Yu-hotspring/BM83/3dmodels/knobs-board-preview.png

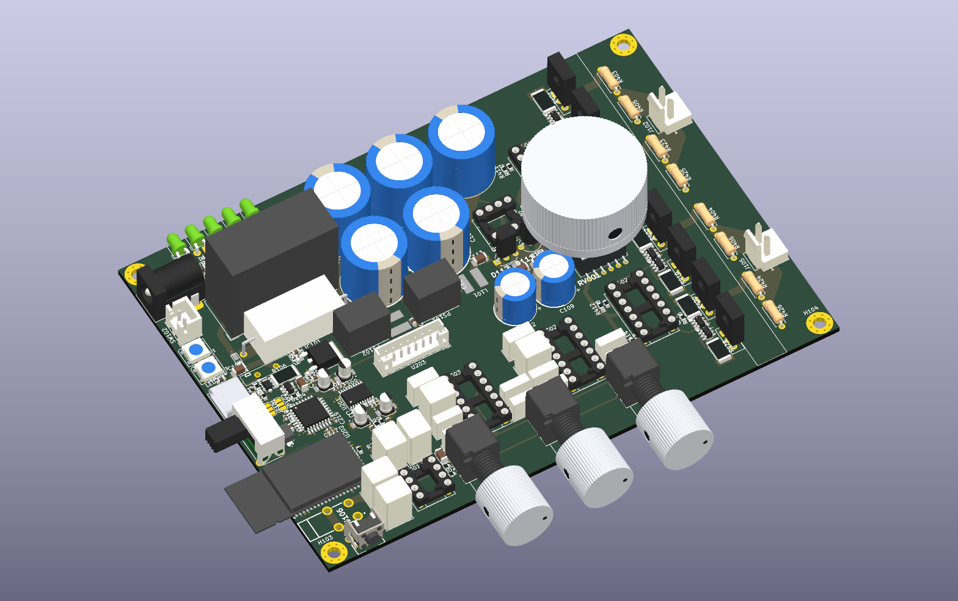
3dmodels/knobs-board-preview.png
