Yu-hotspring/BM83/README.md

| Designator | Footprint | Quantity | Value | URL |
|---|---|---|---|-----|
| C101, C102, C103, C108, C110, C111, C301, C302, C303, C401, C402 | 1206 | 11 | 0.1u | [URL](https://www.digikey.jp/ja/products/detail/walsin-technology-corporation/1206B104K500CT/9355102) |
| C104, C105, C106, C107, C121 | CP_Radial_D16.0mm_P7.50mm | 5 | 1000u | [URL](https://akizukidenshi.com/catalog/g/g108442/) |
| C109, C112 | CP_Radial_D10.0mm_P5.00mm | 2 | 470u | [URL](https://akizukidenshi.com/catalog/g/g102719/) |
| C113, C114 | 1206 | 2 | 4.7u | [URL](https://akizukidenshi.com/catalog/g/g115634/) |
| C115, C116 | 0603 | 2 | 4.7u | [URL](https://akizukidenshi.com/catalog/g/g109218/) |
| C117, C118, C202, C203, C304, C310 | C_Rect_L7.2mm_W6.0mm_P5.00mm | 6 | 1u | [URL](https://akizukidenshi.com/catalog/g/g114602/) |
| C119 | 0603 | 1 | 0.33u | [URL](https://www.digikey.jp/ja/products/detail/samsung-electro-mechanics/CL10B334KO8NNNC/3887706) |
| C120 | 0603 | 1 | 2.2u | [URL](https://akizukidenshi.com/catalog/g/g116077/) |
| C201, C204 | 0402 | 2 | 2.2n | [URL](https://www.digikey.jp/ja/products/detail/kemet/C0402C222J3GEC7411/8645834) |
| C205, C212 | 0402 | 2 | 2.2u | [URL](https://www.digikey.jp/ja/products/detail/taiyo-yuden/LMK105BJ225KV-F/7403747) |
| C206, C208, C210, C213, C216, C219, C215 | 0402 | 7 | 0.1u | [URL](https://www.digikey.jp/ja/products/detail/murata-electronics/GRM155R71H104KE14D/4906220) |
| C207, C209, C211, C214 | CP_Elec_3x5.3 | 4 | 10u | [URL](https://www.digikey.jp/ja/products/detail/w%C3%BCrth-elektronik/865090368008/9836336) |
| C217 | 0402 | 1 | 0.01u | [URL](https://www.digikey.jp/ja/products/detail/cal-chip-electronics-inc/GMC04X7R103K50NT/22461304) |
| C218 | 0402 | 1 | 4.7u | [URL](https://www.digikey.jp/ja/products/detail/taiyo-yuden/JMK105BBJ475MV-F/2573874) |
| C305, C311 | C_Rect_L7.2mm_W2.5mm_P5.00mm | 2 | 0.1u | [URL](https://akizukidenshi.com/catalog/g/g114597/) |
| C306, C312 | C_Rect_L7.2mm_W2.5mm_P5.00mm | 2 | 0.01u | [URL](https://akizukidenshi.com/catalog/g/g114592/) |
| C307, C313 | C_Rect_L7.2mm_W3.5mm_P5.00mm | 2 | 0.22u | [URL](https://akizukidenshi.com/catalog/g/g114599/) |
| C308, C314 | C_Rect_L7.2mm_W2.5mm_P5.00mm | 2 | 0.022u | [URL](https://akizukidenshi.com/catalog/g/g114594/) |
| C309, C315 | C_Rect_L7.2mm_W2.5mm_P5.00mm | 2 | 2200p | [URL](https://akizukidenshi.com/catalog/g/g114589/) |
| D101, D102 | LED_D3.0mm_Horizontal_O1.27mm_Z2.0mm | 2 | LED | [URL](https://akizukidenshi.com/catalog/g/g111577/) |
| D103 | LED_D3.0mm_Horizontal_O1.27mm_Z2.0mm | 1 | LED | [URL](https://akizukidenshi.com/catalog/g/g111639/) |
| D104, D105 | LED_D3.0mm_Horizontal_O1.27mm_Z2.0mm | 2 | LED | [URL](https://akizukidenshi.com/catalog/g/g111637/) |
| D106, D110 | US2H | 2 | CUHS20S60 | [URL](https://akizukidenshi.com/catalog/g/g116578/) |
| D107 | D_SOD-123F | 1 | SMF24A | [URL](https://www.digikey.sg/en/products/detail/littelfuse-inc/SMF24A/3672403) |
| D108, D109 | D_SOD-882 | 2 | PESD5V0S1UL | [URL](https://www.digikey.sg/en/products/detail/nexperia-usa-inc/PESD5V0S1ULSYL/16368528) |
| D111, D112 | US2H | 2 | CUHS20F30 | [URL](https://akizukidenshi.com/catalog/g/g116577/) |
| F101 | MFRX110720 | 1 | Polyfuse | [URL](https://akizukidenshi.com/catalog/g/g113586/) |
| FB101 | 0603 | 1 | 60 | [URL](https://akizukidenshi.com/catalog/g/g104442/) |
| FB102 | 0805 | 1 | 33 | [URL](https://akizukidenshi.com/catalog/g/g106982/) |
| IC101 | TO-252-2 | 1 | NJM2845DL1-33 | [URL](https://akizukidenshi.com/catalog/g/g111299/) |
| J101 | USB_C_Receptacle_HRO_TYPE-C-31-M-12 | 1 | USB_C_Receptacle_USB2.0 | [URL](https://akizukidenshi.com/catalog/g/g114356/) |
| J102, J105 | JST_VH_B2P-VH_1x02_P3.96mm_Vertical | 2 | JST_VH | [URL](https://www.digikey.jp/ja/products/detail/jst-sales-america-inc/B2P-VH/926547) |
| J103 | BarrelJack_Horizontal | 1 | Jack-DC | [URL](https://akizukidenshi.com/catalog/g/g106568/) |
| J104 | fuse_holder | 1 | 3557-2 | [URL](https://www.digikey.jp/ja/products/detail/keystone-electronics/3557-2/2137305) |
| J106 | MJ-8435 | 1 | AudioJack3 | [URL](https://akizukidenshi.com/catalog/g/g109060/) |
| K101 | Relay_SPDT_Omron_G2RL-1-E | 1 | G2R-1-E 24V | [URL](https://ja.aliexpress.com/item/1005009611697631.html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) |
| L101, L102 | 744774033 | 2 | 3.3u | [URL](https://www.digikey.jp/ja/products/detail/w%C3%BCrth-elektronik/744774033/1638670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) |
| LED201, LED202 | LED_WS2812B_PLCC4_5.0x5.0mm_P3.2mm | 2 | WS2812B | [URL](https://akizukidenshi.com/catalog/g/g131923/) |
| PS101 | M78A | 1 | M78AR05-0.5 | [URL](https://akizukidenshi.com/catalog/g/g107179/) |
| PS102 | M78A | 1 | M78AR033-0.5 | [URL](https://akizukidenshi.com/catalog/g/g107178/) |
| Q101 | TO-92L_Inline_Wide | 1 | 2SC1815 | [URL](https://akizukidenshi.com/catalog/g/g117089/) |
| Q102 | TO-92L_Inline_Wide | 1 | 2SA1015 | [URL](https://akizukidenshi.com/catalog/g/g117091/) |
| Q401, Q402, Q407, Q408, Q409, Q410, Q415, Q416 | SOT-23-6 | 8 | TPC6901A | [URL](https://akizukidenshi.com/catalog/g/g113875/) |
| Q403, Q404, Q411, Q412 | TO-126-3_Vertical | 4 | 2SA1359 | [URL](https://akizukidenshi.com/catalog/g/g110042/) |
| Q405, Q406, Q413, Q414 | TO-126-3_Vertical | 4 | 2SC3422 | [URL](https://akizukidenshi.com/catalog/g/g109669/) |
| R101, R102, R103, R104, R105, R111, R113, R205, R206, R411, R412, R413, R414, R417, R418, R421, R422 | 0603 | 17 | 10k | [URL](https://akizukidenshi.com/catalog/g/g130355/) |
| R106, R401, R402, R409, R410, R419, R420, R427, R428 | 2512 | 9 | 1k | [URL](https://akizukidenshi.com/catalog/g/g109461/) |
| R107 | 0603 | 1 | 200k | [URL](https://www.digikey.jp/ja/products/detail/susumu/RG1608P-204-B-T5/1240508) |
| R108, R109 | 0603 | 2 | 5.1k | [URL](https://akizukidenshi.com/catalog/g/g130338/) |
| R110 | CEMENT_RESISTOR_5W | 1 | 50 | [URL](https://akizukidenshi.com/catalog/g/g103995/) |
| R112 | 0603 | 1 | 220 | [URL](https://akizukidenshi.com/catalog/g/g113833/) |
| R114, R115, R201, R204 | 0603 | 4 | 100k | [URL](https://akizukidenshi.com/catalog/g/g130357/) |
| R202, R203 | 0603 | 2 | 470 | [URL](https://akizukidenshi.com/catalog/g/g130349/) |
| R207, R209 | 0603 | 2 | 13.3k | [URL](https://www.digikey.jp/ja/products/detail/panasonic-industry/ERJ-3EKF1332V/196112) |
| R208, R210, R211 | 0603 | 3 | 1k | [URL](https://akizukidenshi.com/catalog/g/g111790/) |
| R301, R302, R309, R310 | 0603 | 4 | 3.3k | [URL](https://www.digikey.jp/ja/products/detail/yageo/RC0603FR-073K3L/727126) |
| R303, R304, R305, R311, R312, R313 | 0603 | 6 | 1.21k | [URL](https://www.digikey.jp/ja/products/detail/yageo/RC0603FR-071K21L/726854) |
| R306, R307, R308, R314, R315, R316 | 0603 | 6 | 26.7k | [URL](https://www.digikey.jp/ja/products/detail/panasonic-industry/ERJ-3EKF2672V/196248) |
| R403, R404, R405, R406, R423, R424, R425, R426 | R_Box_L13.0mm_W4.0mm_P9.00mm | 8 | 0.22 | [URL](https://akizukidenshi.com/catalog/g/g117487/) |
| R407, R408, R415, R416 | 0603 | 4 | 40k | [URL](https://www.digikey.jp/ja/products/detail/yageo/RT0603BRD0740KL/7708329) |
| RV301, RV302, RV303 | RV_2C | 3 | 10k | [URL](https://akizukidenshi.com/catalog/g/g112576/) |
| RV401 | RK12L12C | 1 | R | [URL](https://akizukidenshi.com/catalog/g/g117473/) |
| SW101 | SW_E-Switch_EG2219_DPDT_Angled | 1 | SW_Slide_DPDT | [URL](https://akizukidenshi.com/catalog/g/g115702/) |
| SW102 | JST_XH_B2B-XH-A_1x02_P2.50mm_Vertical | 1 | SW_SPST | [URL](https://akizukidenshi.com/catalog/g/g112247/) |
| SW201 | TVAF06A020BR | 1 | SW_Push | [URL](https://akizukidenshi.com/catalog/g/g114888/) |
| SW202 | SKHHLPA010 | 1 | SW_Push | [URL](https://akizukidenshi.com/catalog/g/g107193/) |
| U101 | SOT-23-6 | 1 | CH221K | [URL](https://akizukidenshi.com/catalog/g/g118022/) |
| U102 | DIP-8_W7.62mm_Socket | 1 | LM358N | [URL](https://akizukidenshi.com/catalog/g/g111167/) |
| U201 | TSSOP-20_4.4x6.5mm_P0.65mm | 1 | PCM5102A | [URL](https://www.digikey.jp/ja/products/detail/texas-instruments/PCM5102AQPWRQ1/4725759) |
| U202 | Microchip_BM83 | 1 | Microchip_BM83 | [URL](https://akizukidenshi.com/catalog/g/g130004/) |
| U203 | JST_PH_B8B-PH-K_1x08_P2.00mm_Vertical | 1 | ST7735S | [URL](https://akizukidenshi.com/catalog/g/g112808/) |
| U204 | LQFP-32_7x7mm_P0.8mm | 1 | STM32G431KBTx | [URL](https://www.digikey.jp/ja/products/detail/stmicroelectronics/STM32G431KBT6/10231564) |
| U301 | DIP-8_W7.62mm_Socket | 1 | TL072 | [URL](https://akizukidenshi.com/catalog/g/g116263/) |
| U302, U303 | DIP-14_W7.62mm_Socket | 2 | TL074 | [URL](https://akizukidenshi.com/catalog/g/g116093/) |
| U401, U402 | DIP-14_W7.62mm_Socket | 2 | LME49740NA | [URL](https://akizukidenshi.com/catalog/g/g103685/) |

## その他の部品

| 部品名 | Quantity | URL |
|---|---|-----|
| ミサイルスイッチ | 1 | [URL](https://akizukidenshi.com/catalog/g/g107058/) |
| OLED | 1 | [URL](https://www.amazon.co.jp/dp/B0CBX29957) |
| つまみ1 | 4 | [URL](https://akizukidenshi.com/catalog/g/g112202/) |
| つまみ2 | 1 | [URL](https://akizukidenshi.com/catalog/g/g112530/) |
| ヒートシンク | 1 | [URL](https://eleshop.jp/shop/g/g1850031/) |
