Yu-hotspring/BM83/3dmodels/README.md

# BM83 プロジェクトの3Dモデル

PCB内の参照はすべて `${KIPRJMOD}/3dmodels/…step`。このフォルダをプロジェクトと一緒に移動すれば参照を維持できます。対象は今回指定された13部品です。

|部品|モデル|根拠・注意|
|---|---|---|
|RV301–303|RV_2C_RK09712200HA.step|回路図にメーカー型番なし。手元のSamacSys製ALPS RK09712200HAモデルを使用。6端子の2.5 mmピッチ、9.5 mm幅の本体が一致するため推定で採用。シャフト先端はフットプリント原点から25 mm（シルクの20 mmより5 mm長い）。実装予定品の軸長は要照合。|
|RV401|RK12L12C0A0E.step|ユーザー指定型番。Alps Alpine RK12Lカタログ図1に基づく簡略モデルを作成。軸径6 mm、LM1=25 mm、Dカット長12 mm／残厚4.5 mm、本体幅12 mm、軸中心は端子列から11 mm、固定脚間13 mm。samacsys:RK12L12Cの6端子位置に整合。ケース奥行・内部積層・小形状と固定脚のばね形状は公称／近似。メーカー製3Dモデルではない。|
|U202|Microchip_BM83.step|回路図のMicrochip BM83に対応する手元のBM83SM1-00ABモデル。基板接触面をZ=0へ調整。|
|J101|USB_C_HRO_TYPE-C-31-M-12.step|フットプリント型番と一致するai03公開モデル。シェル取付脚を基準に位置・向きを調整。|
|R110|CEMENT_RESISTOR_5W.step|回路図は51 Ω、独自5Wフットプリントで型番なし。22×10×9 mm本体、28 mm端子ピッチの汎用モデルを新規作成。高さは公称値で、実部品の確定寸法ではない。|
|K101|G2R-1-E-DC24.step|回路図の値G2R-1-E 24Vに対応する手元のSamacSysモデル。ユーザー確認済み。G2RL用に設定されていた参照を交換。|
|J104|Keystone_3557-2_simplified.step|3557-2のメーカー図面をもとに作成。19.8×6.8×7.4 mm、脚長2.8 mm。端子配置は既存フットプリント13.47×3.4 mmに合わせた。接点ばね・樹脂細部は簡略化。ヒューズ本体は含まない。|
|PS101、PS102|M78AR-0.5.step|MINMAXのM78AR-0.5シリーズ公式STEP。05と033は同一ケース。上下反転・端子列位置を調整。|
|J102、J105|JST_B2P-VH.step|PCB-3D公開のB2P-VH(LF)(SN)モデル。3.96 mmピッチ、メーカー図面の外形と照合し位置・向きを調整。|

## 入手先と原本

- MINMAX公式製品ページ: https://www.minmaxpower.com/en/product/M78AR-0.5
- MINMAX公式STEP ZIP: https://www.minmaxpower.com/storage/media/Product-MINMAX/M78AR-0.5/M78AR-0_5_3D_Mechanical.zip
- USB-C STEP: https://github.com/ai03-2725/Type-C.pretty/blob/master/HRO%20%20TYPE-C-31-M-12.step
- JST STEP: https://www.pcb-3d.com/wordpress/models/jst_b2p-vhlfsn_hdr_th_3-96mm_pitch_v/
- JSTメーカー図面: https://www.jst-mfg.com/product/pdf/eng/eVH.pdf
- Keystoneメーカー製品ページ: https://www.keyelco.com/product.cfm/product_id/296
- Keystoneメーカー図面: https://www.keyelco.com/product-pdf.cfm?p=296
- 図面取得元（Keystoneカタログp.41の写し）: https://www.micro-semiconductor.com/datasheet/97-3557.pdf
- セメント抵抗の公称ケース寸法参考: https://www.yeso.com.tw/en/products.php?cid=11
- RK097、G2R、BM83の原本: ユーザーの既存 `Desktop/Robocon/LL` に保存されていたSamacSysモデル。再取得不要で利用。
- RK12L12C0A0E公式製品ページ: https://tech.alpsalpine.com/e/products/detail/RK12L12C0A0E/
- RK12L公式寸法図（図1、2ページ目）: https://tech.alpsalpine.com/cms.media/product_catalog_rv_02_rk12l_zh_hans_66dbab3690.pdf （`sources/RK12L_catalog.pdf` に保存）

`sources/` に取得原本と寸法資料を保存。外部モデルの権利は各提供元に帰属します。配置調整したモデルを含め、第三者モデルを独自のライセンスで再許諾するものではありません。

## 再生成

CadQuery 2.6以降の環境で `python 3dmodels/build_models.py` を実行すると、正規化した8種類のSTEPを再生成できます。単位はmm、PCB上面をZ=0、上方向を+Zとし、モデルYはKiCadフットプリントYと逆向きです。PCB側のオフセット・回転はすべて0、倍率は1です。

RK12L12C0A0Eは `python 3dmodels/build_rk12l.py` で別途再生成できます。取付面Z=0、端子先端Z=-3.5 mm、軸先端Z=25 mm。PCB側のオフセット・回転は0、倍率は1です。

## 回路図の不整合（今回は変更しない）

K101は値欄がオムロンG2R-1-E 24Vですが、Manufacturer_Name/Manufacturer_Part_Number/Datasheet/Heightなどの補助属性がDURAKOOL DG85Bのままです。ユーザーの指定によりG2Rの3Dモデルを使用しています。部品調達に補助属性を使う際は別途修正が必要です。

RV301–303とR110は実装品のメーカー型番が回路図にないため、筐体の厳密な干渉検討には現物寸法の確認が必要です。

## つまみ付きモデル（2026-11-01）

PCBでは以下の組立モデルを使用。元のつまみ無しSTEPも残しています。

|部品|PCBで使用するモデル|取付位置|
|---|---|---|
|RV401 (RK12)|RK12L12C0A0E_with_K-59-M-AG.step|K-59-M-AG: 外径30、高さ16、軸穴6.1、穴深さ12 mm。軸先端Z=25に穴底を合わせ、底面Z=13、上面Z=29 mm。軸中心X=5,Y=11。|
|RV301–303 (RK09)|RV_2C_RK09712200HA_with_K-29-6.1.step|K-29-6.1: 外径13.7、高さ13.5、軸穴6.1、穴深さ11.6 mm。既存RK097モデルの軸(+X方向、Y=2.5,Z=6.5)に取り付け。軸先端X=25、つまみ底面X=13.4、上面X=26.9 mm。|

単位mm、位置はモデル座標（KiCadフットプリントYと逆向き）。穴の奥まで差し込む想定で、パネル厚や任意の取付すき間は加算していません。K-29-6.1の外周はZ=-0.35まで達するため、基板端から外側に出して使う配置を想定します。RK09本体の型番推定は従来通りです。

メーカー寸法図をもとに作成した簡略モデルです。外形、軸穴、底面逃げ、止めねじ位置を反映。ローレットの歯数・深さ、小さな面取り、指標の形状は近似で、ねじ山は省略。メーカーSTEPの配布は会員向けだったため、公開寸法図から作成しました。

- K-59寸法図: https://www.satoparts.co.jp/products/search/K/K-59/demension
- K-29-6.1寸法図: https://www.satoparts.co.jp/products/search/K/K-29-6_1/demension
- 図面原本: `sources/K-59_dimension.gif`、`sources/K-29-6.1_dimension.gif`
- 再生成: `python 3dmodels/build_knobs.py`（CadQuery）。つまみ単体2種と組立STEP2種を生成。STEP再読込による形状検査、軸とつまみの交差体積0を確認。
