Yu-hotspring/BM83/PCB_GND・層構成設計メモ.md

# PCBのGND・層構成・音声AC結合 設計メモ

## 1. 対象

BM83、STM32、PCM5102A、アナログイコライザ、パワーアンプを同一基板に実装する際の、以下の設計方針をまとめる。

- GNDPWR、GNDD、AGND、GNDREFの扱い
- フェライトビーズと一点接地
- 4層・6層基板の層構成
- 各信号層への配線割り当て
- ライン入力およびPCM5102A出力のAC結合

対象回路図：[BM83.kicad_sch](./BM83.kicad_sch)

## 2. 結論

1. **GNDPWR、GNDD、AGNDは原則として同一の0 V GNDに統合する。**
2. **GNDREFはGNDではない。約VDD/2の仮想中点なので、0 V GNDへ接続しない。**
3. GND間にフェライトビーズを入れず、必要なら`+3.3VA`などの電源供給側へ入れる。
4. GNDプレーンは分割せず、機能ブロックの配置と電流経路でノイズを分離する。
5. 6層の場合は、L2とL5を全面GND、L3を電源、L4をデジタル信号層とする。

## 3. 各GNDの意味

| ネット | 実際の役割 | 推奨処置 |
|---|---|---|
| GNDPWR | 電源入力負極、パワー段の0 V | 共通0 Vへ統合 |
| GNDD | BM83、STM32、USB、表示回路などの0 V | 共通0 Vへ統合 |
| AGND | PCM5102A、アナログ用電源などの0 V | 共通0 Vへ統合 |
| GNDREF | アナログ回路の仮想中点、約VDD/2 | 0 Vから完全に分離し、`VBIAS`または`VMID`へ改名 |

現在の回路では、U103AとQ101/Q102がGNDREFを生成している。この構成は概ね次の関係になる。

```text
V+      = VDD
V-      = 共通0 V
GNDREF  ≒ VDD / 2
```

したがって、AGNDとGNDREFをNetTie、0 Ω抵抗、フェライトビーズのいずれで接続しても、仮想中点を0 Vへ短絡することになる。

## 4. GND接続方針

### 4.1 GNDPWRとGNDD

原則として同一ネットにする。パワーアンプの大電流をデジタル領域へ流さないためにGNDを分割するのではなく、以下で対処する。

- DC入力、バルクコンデンサ、パワーアンプ、スピーカー端子を近接配置する。
- 出力段の電源電流を短く太い銅箔でバルクコンデンサへ戻す。
- パワー段の戻り経路上にBM83、STM32、DACを配置しない。
- 必要に応じてL1/L6のGNDポアや太配線でパワー段の戻りを補強する。

回路図上でネットを分けて検証したい場合、NT101はバルクコンデンサ負極付近に配置し、低インピーダンスのNetTieまたは0 Ωで接続する。最終的には同一GNDネットに統合する方が実装ミスは少ない。

### 4.2 GNDDとAGND

同一の連続GNDプレーンへ接続する。特にPCM5102AのAGND、DGND、CPGNDは、デバイス付近の同じ低インピーダンス銅箔へ接続し、各ピンの近くにGND Viaを配置する。

デジタルノイズはGND分割ではなく、次の配置で抑える。

- PCM5102Aのデジタル端子側をBM83/STM32へ向ける。
- アナログ出力端子側をイコライザへ向ける。
- BCK、LRCK、DINをアナログ出力およびオペアンプ入力から離す。
- クロック配線とアナログ配線を長距離で平行にしない。

### 4.3 AGNDとGNDREF

**接続しない。一点接地もしない。**

GNDREFはアナログ領域内だけの局所的な太配線または小さなポアとし、以下に限定して使用する。

- イコライザのバイアス抵抗
- オペアンプの信号基準
- パワーアンプの信号基準
- AC結合後の入力バイアス

外部コネクタのSleeve、USB GND、測定器GNDには接続しない。

## 5. フェライトビーズ

GND間にフェライトビーズを入れると、戻り電流に周波数依存のインピーダンスが追加され、GND電位差、リターン経路の迂回、共振を生じる可能性がある。

FB101はGND間ではなく、必要なら次のようにアナログ電源側へ配置する。

```text
+3.3V ── Ferrite Bead ── +3.3VA
                           │
                        0.1 µF
                           │
                        共通GND
                           │
                         10 µF
                           │
                        共通GND
```

フェライトビーズは、対象となるスイッチング周波数・クロック周波数でのインピーダンス、定格電流、DC抵抗を確認して選定する。必ず近傍にデカップリングコンデンサを置く。

## 6. 基板上の機能配置

推奨する大まかな配置順は次のとおり。

```text
DC入力・保護・バルクC
        │
パワーアンプ・スピーカー端子
        │
イコライザ・ライン入力
        │
PCM5102A
        │
BM83・STM32・表示・USB
```

PCM5102Aをアナログ領域とデジタル領域の境界に置き、パワーアンプ出力およびスイッチング電源をライン入力・DAC出力から離す。

## 7. 4層基板の推奨構成

| 層 | 割り当て | 主な用途 |
|---|---|---|
| L1 | 部品・信号 | アナログ信号、USB、デカップリング、大電流の局所配線 |
| L2 | 全面GND | GNDPWR/GNDD/AGNDを統合した共通0 V |
| L3 | 電源 | VDD/V+、+5 V、+3.3 V、+3.3VA、局所VBIAS |
| L4 | 信号・補助配線 | 低速デジタル、制御信号、GNDポア、大電流補強 |

L1-L2間を薄くし、L1信号の直下に連続したGND面を確保する。L4の信号はGND Viaを適切に配置してリターン経路を確保する。

## 8. 6層基板の推奨構成

この基板では、**L4は信号レイヤ**とする。

| 層 | 割り当て | 主な用途 |
|---|---|---|
| L1 | 部品・重要信号 | アナログ音声、USB、短い重要配線、大電流の局所配線 |
| L2 | 全面GND | L1信号の基準面、共通0 V |
| L3 | 電源 | VDD/V+、+5 V、+3.3 V、+3.3VA、局所VBIAS |
| L4 | 内層信号 | I2S、UART、SPI、クロック、デジタル制御 |
| L5 | 全面GND | L4/L6信号の基準面、共通0 V |
| L6 | 裏面信号・補助電力 | GPIO、LED、スイッチ、低速制御、大電流補強 |

```text
L1  Signal / Components
L2  Solid GND
L3  Power
L4  Digital Signal
L5  Solid GND
L6  Slow Signal / Power reinforcement
```

L1-L2間、L4-L5間、L5-L6間を可能な範囲で薄くする。L2とL5は多数のGND Viaで接続する。

### 8.1 L1に配線する信号

アナログ信号は可能な限りL1だけで完結させ、Viaを避ける。

- PCM5102AのOUTL/OUTR
- 470 Ω＋2.2 nF出力フィルタ
- AC結合コンデンサ周辺
- イコライザ入力・出力
- オペアンプ帰還ループ
- パワーアンプ入力
- J106ライン入力

USB D+/D-も、コネクタから切替回路およびBM83/STM32までL1で差動配線する。

- ペア幅・間隔を一定にする。
- 分岐やスタブを短くする。
- アナログ音声領域から離す。
- 直下のL2を切らない。

アナログ信号とUSBが同じL1に存在しても、基板上の領域を分離すればよい。

### 8.2 L4に配線する信号

L4はデジタル内部配線を主体とする。

- BCK
- LRCK
- DIN
- MCLKを使用する場合
- UART
- SPI
- SWD
- OLED制御
- BM83制御GPIO
- MCU内部接続

L4の主基準面はL5とする。L4にはアナログ音声、オペアンプ帰還、パワーアンプ出力、VBIAS、スイッチング電源のSWノードを配線しない。

### 8.3 L6に配線する信号

L6はノイズ感度の比較的低い信号と補助配線に使用する。

- LED
- スイッチ
- リレー制御
- PowerOn
- 音量・再生制御GPIO
- 低速UART
- Reset、Enable
- デバッグ信号
- L1/L4で引けない低速信号

L6の主基準面はL5とする。パワーアンプ出力やリレー駆動と、アナログ入力を平行に走らせない。

### 8.4 層変更時のリターンVia

信号がL1からL4/L6へ層変更する場合、信号Viaのすぐ近くにL2-L5間のGND Viaを置く。信号電流の戻り道も同時に層変更できるようにする。

特に以下ではGND Viaを密に配置する。

- 基板外周
- コネクタ周辺
- PCM5102A周辺
- パワーアンプ周辺
- デカップリングコンデンサ付近
- 信号Via付近

## 9. L3電源プレーン

L3は信号配線には使用せず、電源島へ割り当てる。

```text
┌──────────┬──────────┬──────────┐
│ VDD / V+ │ +5/+3.3V │ +3.3VA   │
│ Power    │ Digital  │ DAC      │
└──────────┴──────────┴──────────┘
                         VBIASは局所配置
```

GNDREF/VBIASは全面プレーンにせず、イコライザ・アンプ領域だけの小さなポアまたは太配線にする。スイッチング電源やパワー電源の真上・真下に+3.3VAやVBIASを重ねない。

## 10. パワーアンプの大電流配線

次のネットは通常の細い信号配線として扱わない。

- VDD/V+
- 出力トランジスタの電源
- OUT_L+ / OUT_L-
- OUT_R+ / OUT_R-
- バルクコンデンサへの戻り経路

L3で電源を分配し、L1/L6の太い銅箔やポアでも補強する。層を移る場合は複数Viaを並列にする。

BTL出力は各チャンネルの+/-を近接して配線する。

```text
OUT_L+  ─────────┐
OUT_L-  ─────────┘ 近接配線

OUT_R+  ─────────┐
OUT_R-  ─────────┘ 近接配線
```

## 11. ライン入力とPCM5102A出力のAC結合

推奨カットオフは約1～3 Hz。可聴帯域下限20 Hzより十分低くし、20 Hzでの振幅低下を無視できる程度にする。

一次ハイパスのカットオフは次式で求める。

```text
fc = 1 / (2πRC)
```

標準値として次を推奨する。

```text
C = 2.2 µF
R = 47 kΩ
fc ≒ 1.54 Hz
```

| バイアス抵抗 | コンデンサ | カットオフ |
|---:|---:|---:|
| 100 kΩ | 0.47 µF | 3.39 Hz |
| 100 kΩ | 1.0 µF | 1.59 Hz |
| 100 kΩ | 2.2 µF | 0.72 Hz |
| 47 kΩ | 1.0 µF | 3.39 Hz |
| 47 kΩ | 2.2 µF | 1.54 Hz |
| 47 kΩ | 4.7 µF | 0.72 Hz |

### 11.1 J106ライン入力

J106のSleeveはGNDREFではなく共通0 Vへ接続する。

```text
J106 Tip/Ring ── 2.2 µF ── SIG_L/R
                               │
                              47 kΩ
                               │
                            GNDREF

J106 Sleeve ─────────────── 共通0 V
```

外部機器のGNDとUSB GNDが同時に接続されても、GNDREFが短絡されない構成にする。

### 11.2 PCM5102A出力

既存の470 Ω＋2.2 nFは高域ノイズ用のローパスであり、低域カット用ではない。その後段にAC結合を追加する。

```text
PCM5102A OUT
     │
   470 Ω
     ├── 2.2 nF ── AGND
     │
   2.2 µF
     │
  EQ入力
     │
    47 kΩ
     │
  GNDREF
```

PCM5102Aの出力は0 V中心だが、現在のイコライザ／アンプはGNDREF≒VDD/2を中心に動作するため、両者の間にAC結合が必要となる。

## 12. AC結合コンデンサの選択

### 第一候補：フィルムコンデンサ

- 2.2 µF、25～50 V
- ポリエステル（MKT/MKS）で十分
- 低歪み、低漏れ、容量の電圧依存性が小さい
- サイズが問題なら1 µF＋100 kΩも使用可能

### 第二候補：低漏れアルミ電解

- 2.2 µF、35 V以上
- 高インピーダンス回路なので低漏れ品を選ぶ
- 正極をGNDREF／アンプ側へ向ける

```text
PCM5102A/J106側 ── |−  +| ── アンプ入力・GNDREF側
```

GNDREF側が約VDD/2だけ高いため、通常は極性付き電解を使用できる。単に「オーディオグレード」であることより、漏れ電流と定格電圧を重視する。

### 原則として避けるもの

信号直列用途のX5R/X7Rセラミックは、DCバイアスによる実効容量低下、電圧依存性、マイクロフォニックノイズがあるため避ける。C0G/NP0は良好だが、1～2.2 µFでは現実的でない。

## 13. 起動・停止時のポップノイズ

`47 kΩ × 2.2 µF`の時定数は約0.10秒で、概ね5時定数に相当する約0.5秒で安定する。

- GNDREFが安定してからパワーアンプのMuteを解除する。
- 電源投入後、少なくとも約0.5秒はMuteする。
- 電源OFF時はGNDREFが崩れる前にMuteする。
- 実機ではGNDREFの立ち上がりをオシロスコープで確認して遅延を決める。

## 14. レイアウトチェックリスト

- [ ] GNDPWR、GNDD、AGNDを共通0 Vへ統合したか
- [ ] GNDREFを0 Vへ接続していないか
- [ ] J106 Sleeveを共通0 Vへ接続したか
- [ ] ライン入力とPCM5102A出力にAC結合を追加したか
- [ ] GND間のフェライトを除去したか
- [ ] 必要なフェライトを電源供給側へ移したか
- [ ] L2/L5をスリットのない全面GNDにしたか
- [ ] I2Sをアナログ信号から離したか
- [ ] 信号Via付近にGNDリターンViaを置いたか
- [ ] オペアンプ帰還ループを最短にしたか
- [ ] パワー段の大電流をバルクコンデンサへ直接戻したか
- [ ] スピーカー出力をライン入力・DAC出力から離したか
- [ ] GNDREF生成回路のsource/sink能力と安定性を確認したか
- [ ] 電源投入・切断時のMute制御を実装したか

## 15. 参考資料

- [TI PCM5102A Datasheet](https://www.ti.com/lit/ds/symlink/pcm5102a.pdf)
- [TI High-Speed Layout Guidelines](https://www.ti.com/lit/an/scaa082a/scaa082a.pdf)
- [TI TWL1200 PCB Design Guidelines](https://www.ti.com/lit/an/scea042/scea042.pdf)
- [Analog Devices MT-031: Grounding Data Converters](https://www.analog.com/media/en/training-seminars/tutorials/MT-031.pdf)
