Yu-hotspring/BM83/実装予定メモ.md

- EQボタン上下長押しで当該チャンネルリセット
- スペアナ表示
- EQ状態表示
- UACもBM83も色々情報取得できるのでいい感じに表示

どうするシリーズ
- 音量調整どうする
    - UAC，BM83，アナログ全てで調整できるがどうするか
        - デフォでどういう状態か調べる
- ケースどうする
    - 金属箱に入れたいよな
    - アクリルのほうが中見えて良さそう
    - そもそも筐体に入れたら通気しないけど大丈夫そう？
- IFの並びどうする
    - Volume調整とEQ調整並ぶと良くないかと思ったけど，つまみの種類変えて分かるようにすることで対策すれば良いかも
