Yu-hotspring/BM83/3dmodels/sources/K-29-6.1_dimension.gif

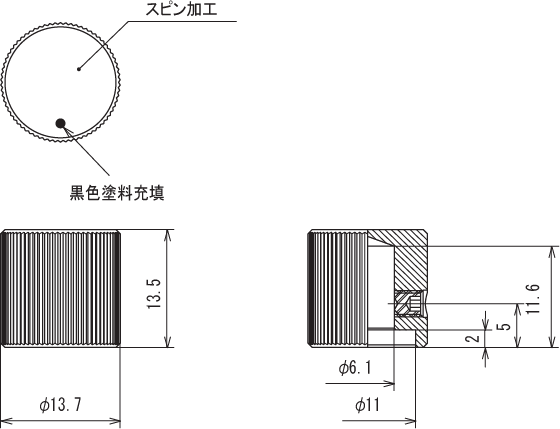
3dmodels/sources/K-29-6.1_dimension.gif
