Yu-hotspring/BM83/3dmodels/sources/K-59_dimension.gif

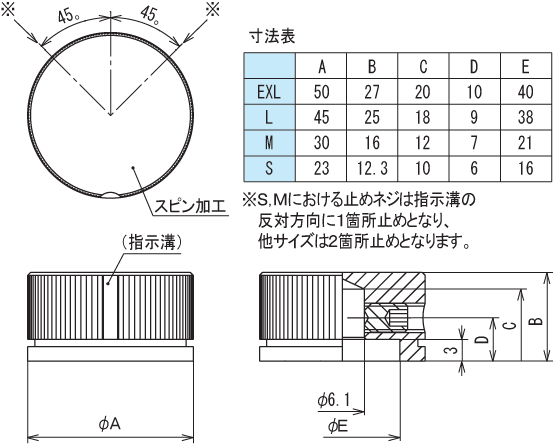
3dmodels/sources/K-59_dimension.gif
