Yu-hotspring/BM83/3dmodels/RV_2C_RK09712200HA_with_K-29-6.1.step

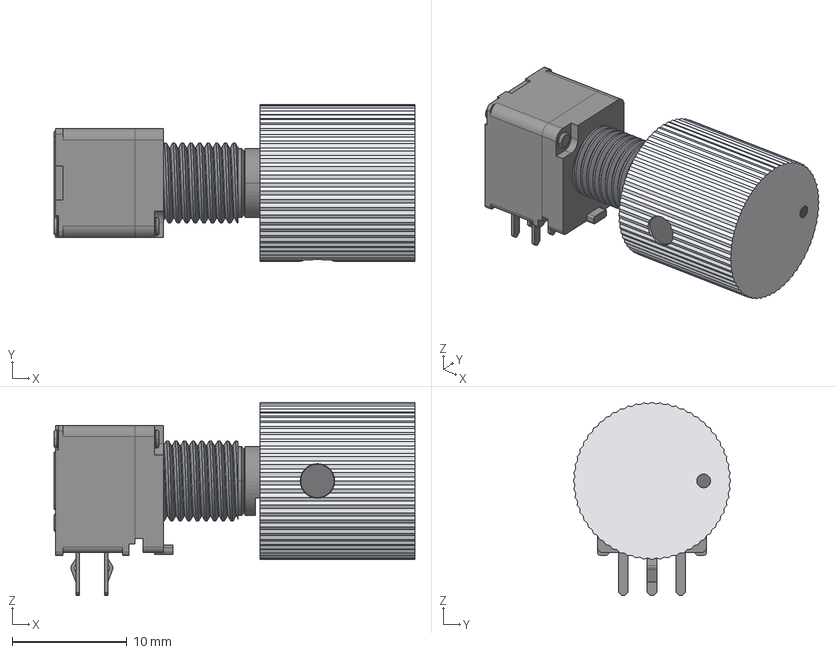
[picture p4: CAD file, 2026-11-01]
3dmodels/RV_2C_RK09712200HA_with_K-29-6.1.step
31.4 x 13.7 x 16.8 mm
potentiometer
aluminium
index_mark
set_screw
