Yu-hotspring/BM83/3dmodels/sources/G2R-1-E-DC24.stp

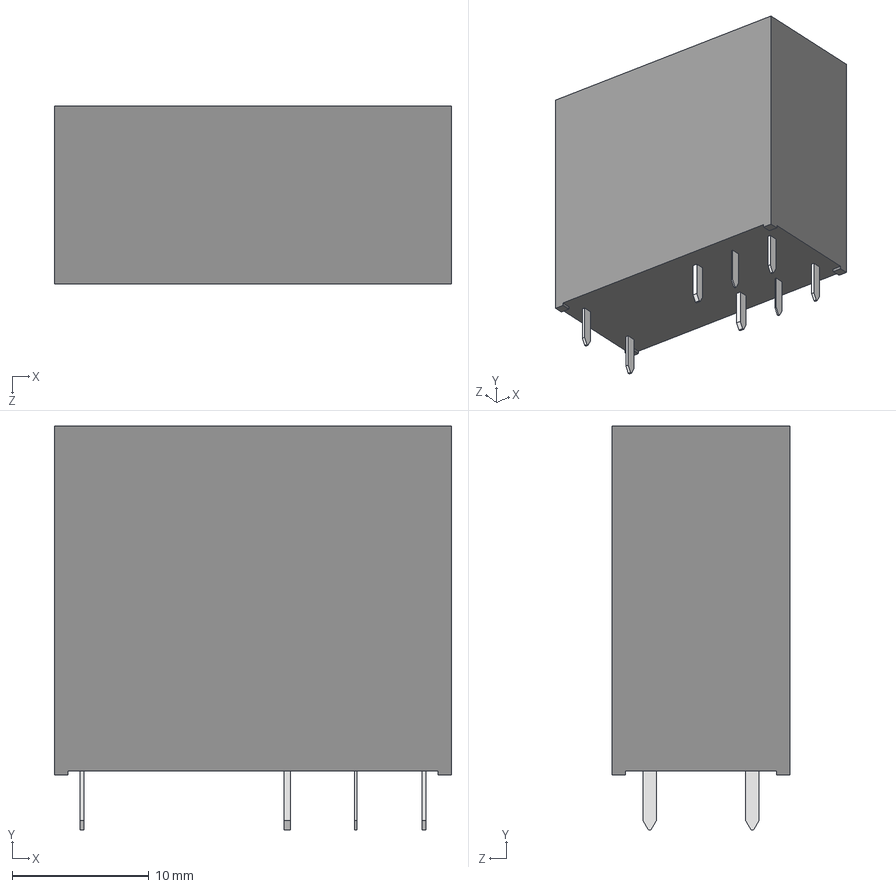
[picture p5: CAD file, 2026-10-27]
3dmodels/sources/G2R-1-E-DC24.stp
29.0 x 29.5 x 13.0 mm
