Yu-hotspring/BM83/BM83.step

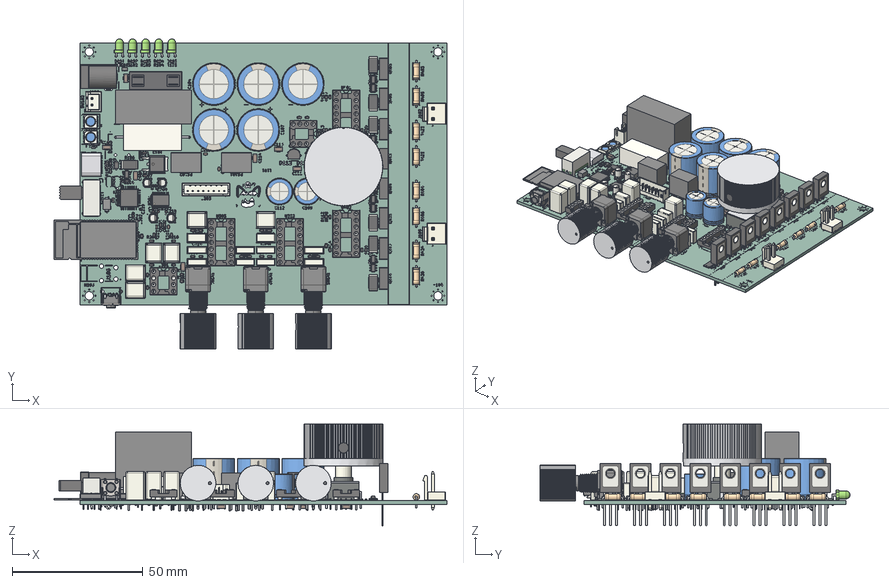
[picture p6: CAD file, 2026-11-01]
BM83.step
150.0 x 118.4 x 38.8 mm
C_Rect_L7.2mm_W2.5mm_P5.00mm x 8
SOT-23-6 x 9
R_0603_1608Metric x 52
R_Axial_DIN0207_L63mm_D25mm_P762mm_Horizontal x 8
LED_D3.0mm_Horizontal_O1.27mm_Z2.0mm x 5
C_Rect_L7.2mm_W3.5mm_P5.00mm x 2
C_Rect_L7.2mm_W6.0mm_P5.00mm x 6
JST_B8B_PH_K
L_0603_1608Metric
C_0402_1005Metric x 10
SKHH°L(3.85_type)_1
SKHH°L(3.85_type)
R_2512_6332Metric x 9
CP_Radial_D160mm_P750mm x 5
JST_B2B_XH_A
TO-126-3_Vertical x 8
potentiometer x 3
aluminium x 4
index_mark x 4
set_screw x 4
C_1206_3216Metric x 13
ceramic
lead_-1
lead_1
TO-92L_Inline_Wide x 2
C_0603_1608Metric x 7
D_SOD-882 x 2
CP_Elec_3x53 x 4
LQFP-32_7x7mm_P0.8mm
DIP_14_W762mm_Socket x 4
Pins
Lugs
932d09b3-9c39-11ed-93f0-dde97e994e83_part
932d09b4-9c39-11ed-93f0-dde97e994e83_part
932d09b5-9c39-11ed-93f0-dde97e994e83_part
housing
metal_cover
shaft_bearing
insulated_D_shaft
terminal_1
terminal_2
terminal_3
terminal_4
terminal_5
terminal_6
mounting_tab_7
mounting_tab_8
SW_E-Switch_EG2219_DPDT_Angled
CP_Radial_D100mm_P500mm x 2
D_SOD_123F
pin_-6.735_-1.7
pin_-6.735_1.7
contact_-6.735_-1.4
contact_-6.735_1.4
pin_6.735_-1.7
pin_6.735_1.7
contact_6.735_-1.4
contact_6.735_1.4
nylon
TSSOP-20_4.4x6.5mm_P0.65mm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
