Yu-hotspring/BM83/logos/Relay_SPDT_953G_1Common_Sealed.step

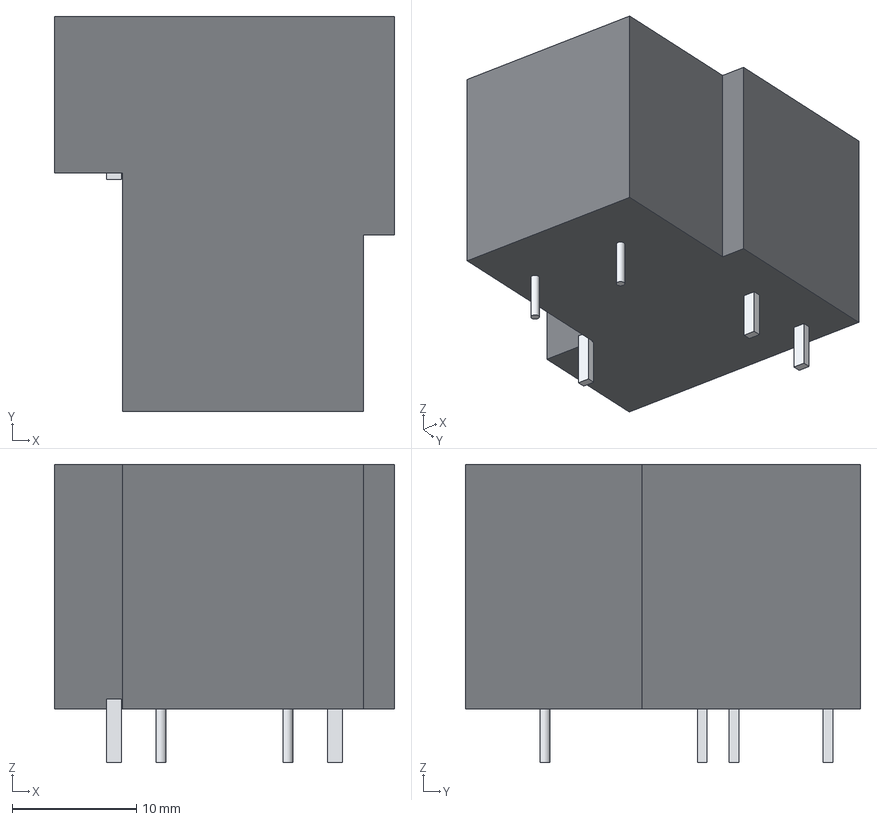
[picture p7: CAD file, 2026-11-03]
logos/Relay_SPDT_953G_1Common_Sealed.step
27.4 x 31.8 x 24.0 mm
Sealed_case_envelope
Terminal_A1
Terminal_A2
Terminal_11
Terminal_12
Terminal_14
