Yu-hotspring/BM83/3dmodels/K-29-6.1.step

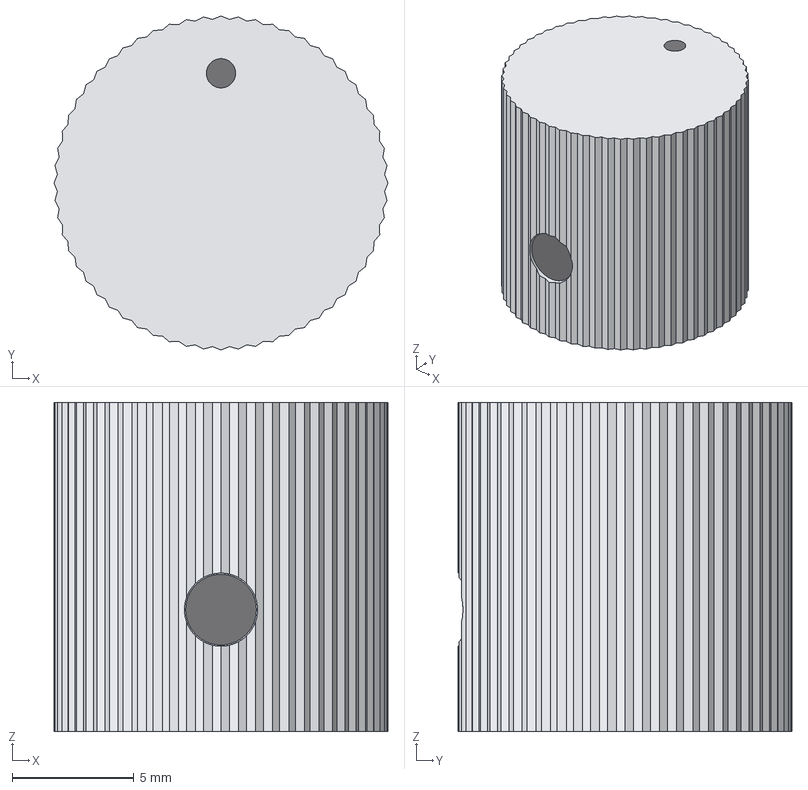
[picture p8: CAD file, 2026-11-01]
3dmodels/K-29-6.1.step
13.7 x 13.7 x 13.5 mm
aluminium
index_mark
set_screw
