Yu-hotspring/BM83/3dmodels/sources/M78AR-0.5 3D Mechanical.stp

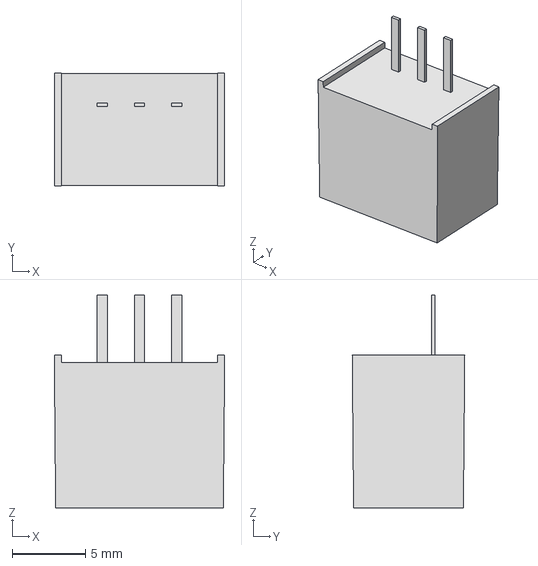
[picture p9: CAD file, 2026-10-27]
3dmodels/sources/M78AR-0.5 3D Mechanical.stp
11.6 x 7.66 x 14.5 mm
