Yu-hotspring/BM83/3dmodels/RK12L12C0A0E_with_K-59-M-AG.step

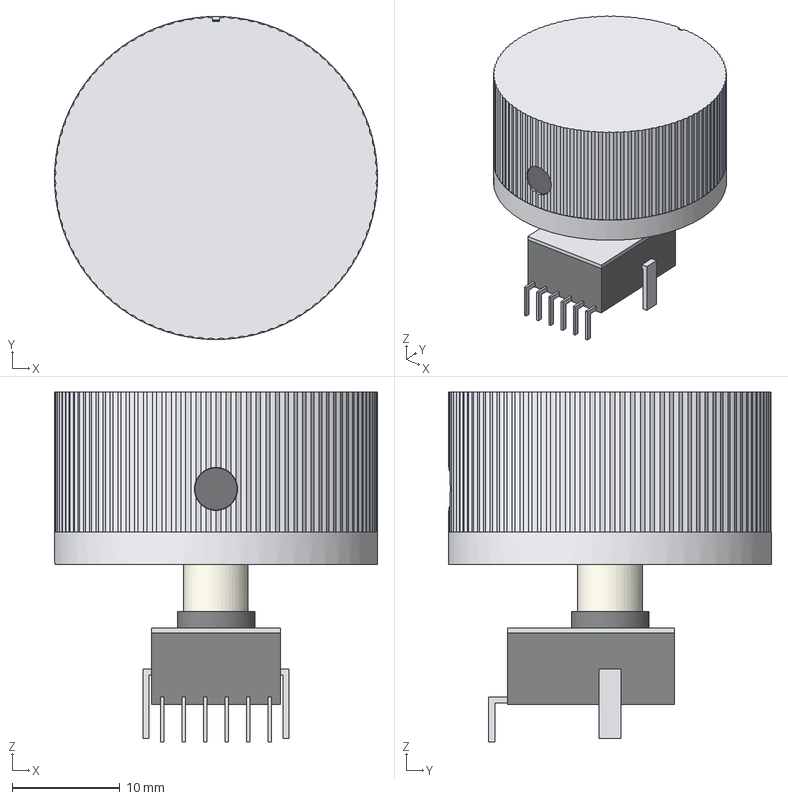
[picture p10: CAD file, 2026-11-01]
3dmodels/RK12L12C0A0E_with_K-59-M-AG.step
30.0 x 30.0 x 32.5 mm
housing
metal_cover
shaft_bearing
insulated_D_shaft
terminal_1
terminal_2
terminal_3
terminal_4
terminal_5
terminal_6
mounting_tab_7
mounting_tab_8
aluminium
index_mark
set_screw
