Yu-hotspring/BM83/3dmodels/sources/JST_B2P-VH.step

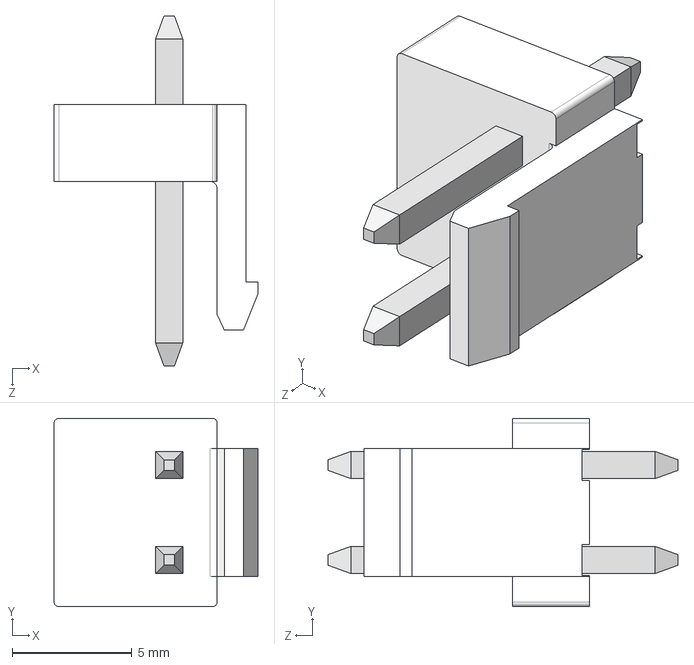
[picture p11: CAD file, 2026-10-27]
3dmodels/sources/JST_B2P-VH.step
8.50 x 7.86 x 14.6 mm
