Yu-hotspring/BM83/3dmodels/K-59-M-AG.step

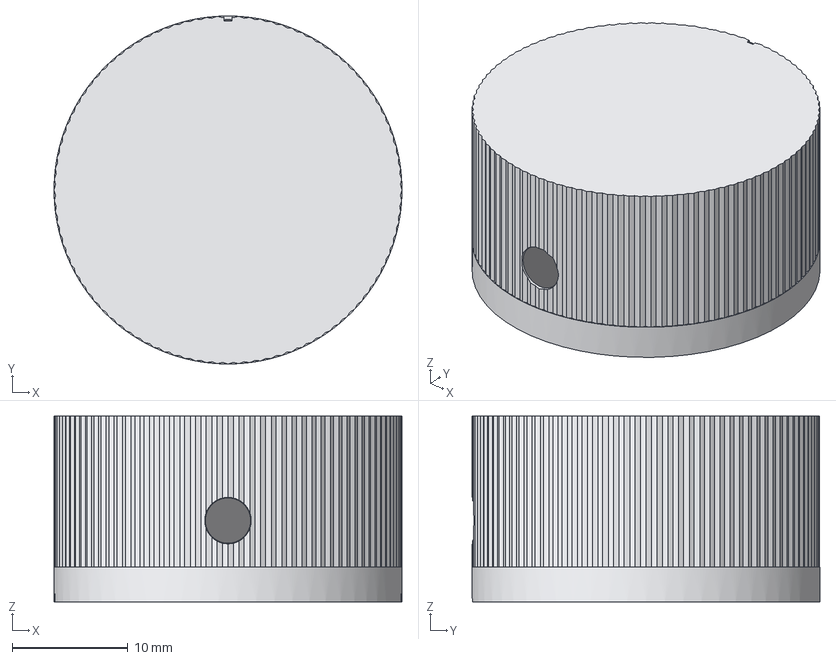
[picture p12: CAD file, 2026-11-01]
3dmodels/K-59-M-AG.step
30.0 x 30.0 x 16.0 mm
aluminium
index_mark
set_screw
