Yu-hotspring/BM83/3dmodels/RK12L12C0A0E.step

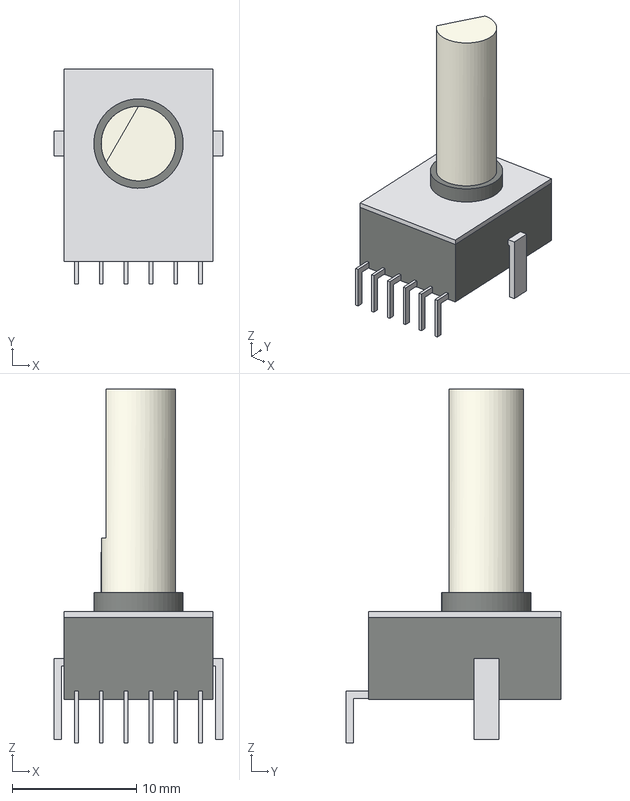
[picture p13: CAD file, 2026-10-31]
3dmodels/RK12L12C0A0E.step
13.6 x 17.3 x 28.5 mm
housing
metal_cover
shaft_bearing
insulated_D_shaft
terminal_1
terminal_2
terminal_3
terminal_4
terminal_5
terminal_6
mounting_tab_7
mounting_tab_8
