Yu-hotspring/BM83/3dmodels/USB_C_HRO_TYPE-C-31-M-12.step

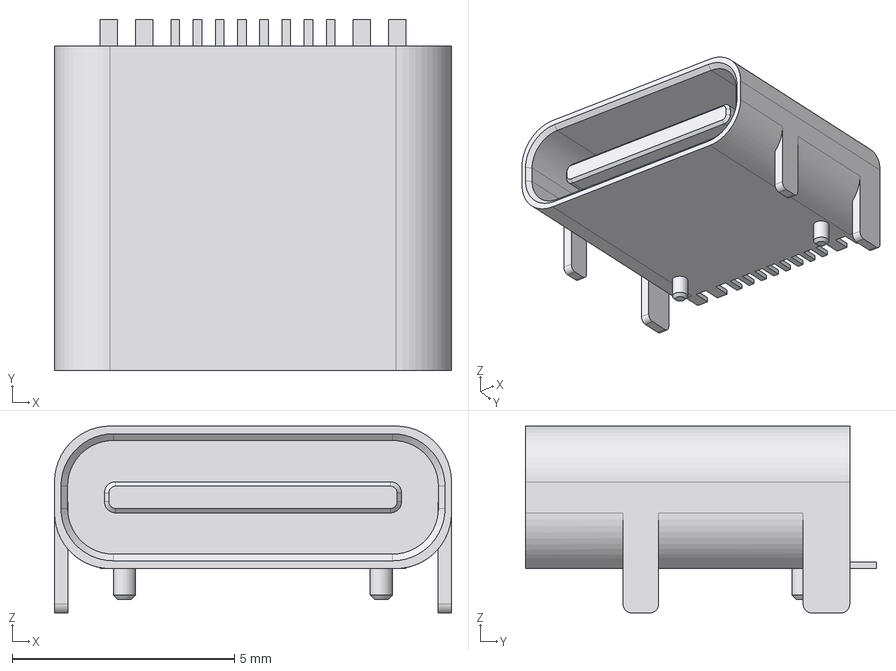
[picture p14: CAD file, 2026-10-27]
3dmodels/USB_C_HRO_TYPE-C-31-M-12.step
8.94 x 7.90 x 4.21 mm
