Yu-hotspring/BM83/3dmodels/Microchip_BM83.step

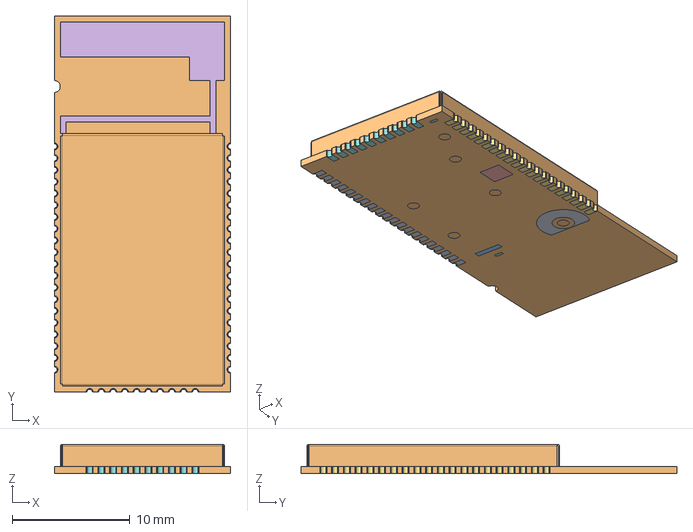
[picture p15: CAD file, 2026-10-27]
3dmodels/Microchip_BM83.step
15.0 x 32.0 x 2.50 mm
