Yu-hotspring/BM83/3dmodels/RV_2C_RK09712200HA.step

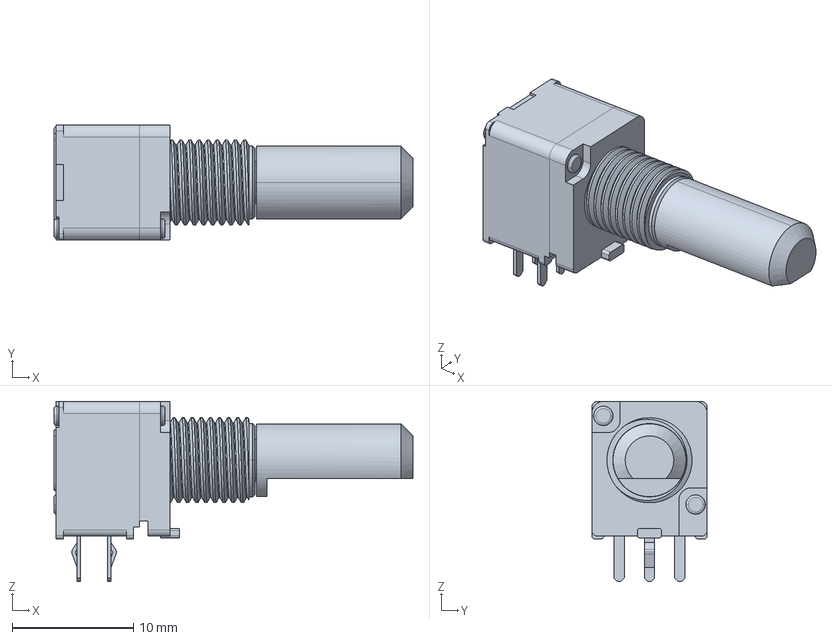
[picture p16: CAD file, 2026-10-27]
3dmodels/RV_2C_RK09712200HA.step
29.6 x 9.50 x 14.8 mm
