Yu-hotspring/BM83/3dmodels/Keystone_3557-2_simplified.step

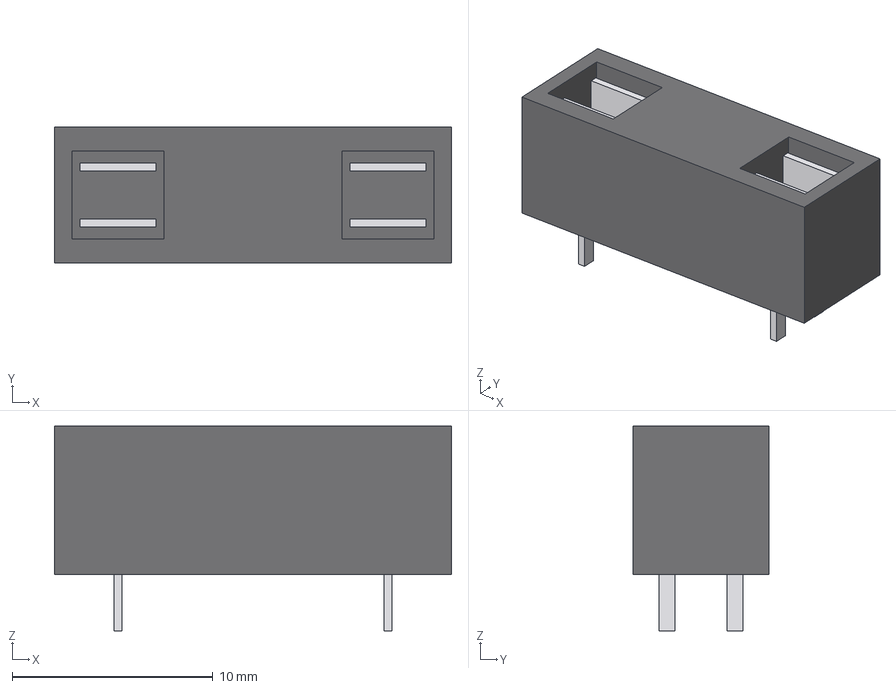
[picture p17: CAD file, 2026-10-27]
3dmodels/Keystone_3557-2_simplified.step
19.8 x 6.80 x 10.2 mm
pin_-6.735_-1.7
pin_-6.735_1.7
contact_-6.735_-1.4
contact_-6.735_1.4
pin_6.735_-1.7
pin_6.735_1.7
contact_6.735_-1.4
contact_6.735_1.4
nylon
