Yu-hotspring/BM83/3dmodels/CEMENT_RESISTOR_5W.step

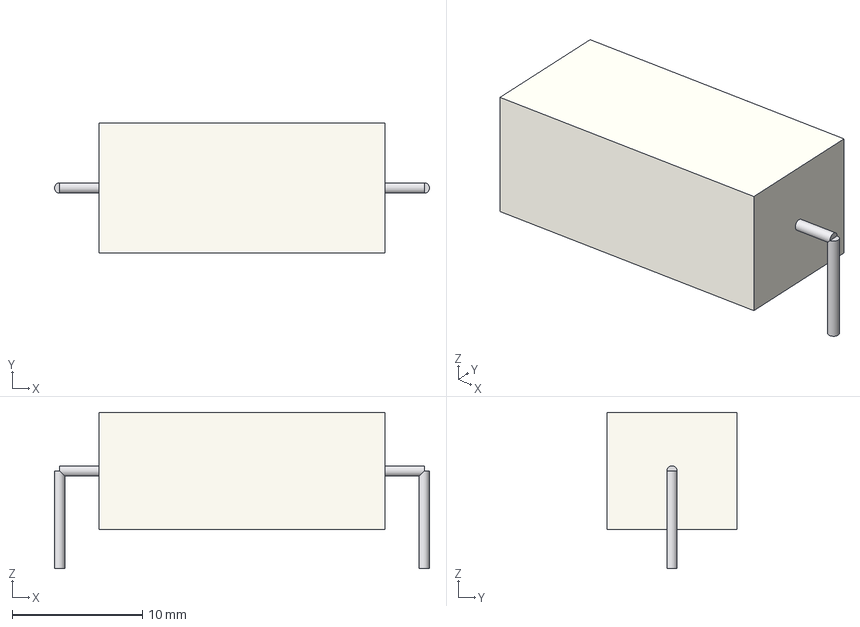
[picture p18: CAD file, 2026-10-27]
3dmodels/CEMENT_RESISTOR_5W.step
28.8 x 10.0 x 12.0 mm
ceramic
lead_-1
lead_1
