Yu-hotspring/BM83/(list of files, cad)

Other CAD files:
3dmodels/G2R-1-E-DC24.step
3dmodels/M78AR-0.5.step
3dmodels/JST_B2P-VH.step
