Yu-hotspring/BM83/BM83-Amplifier.pdf

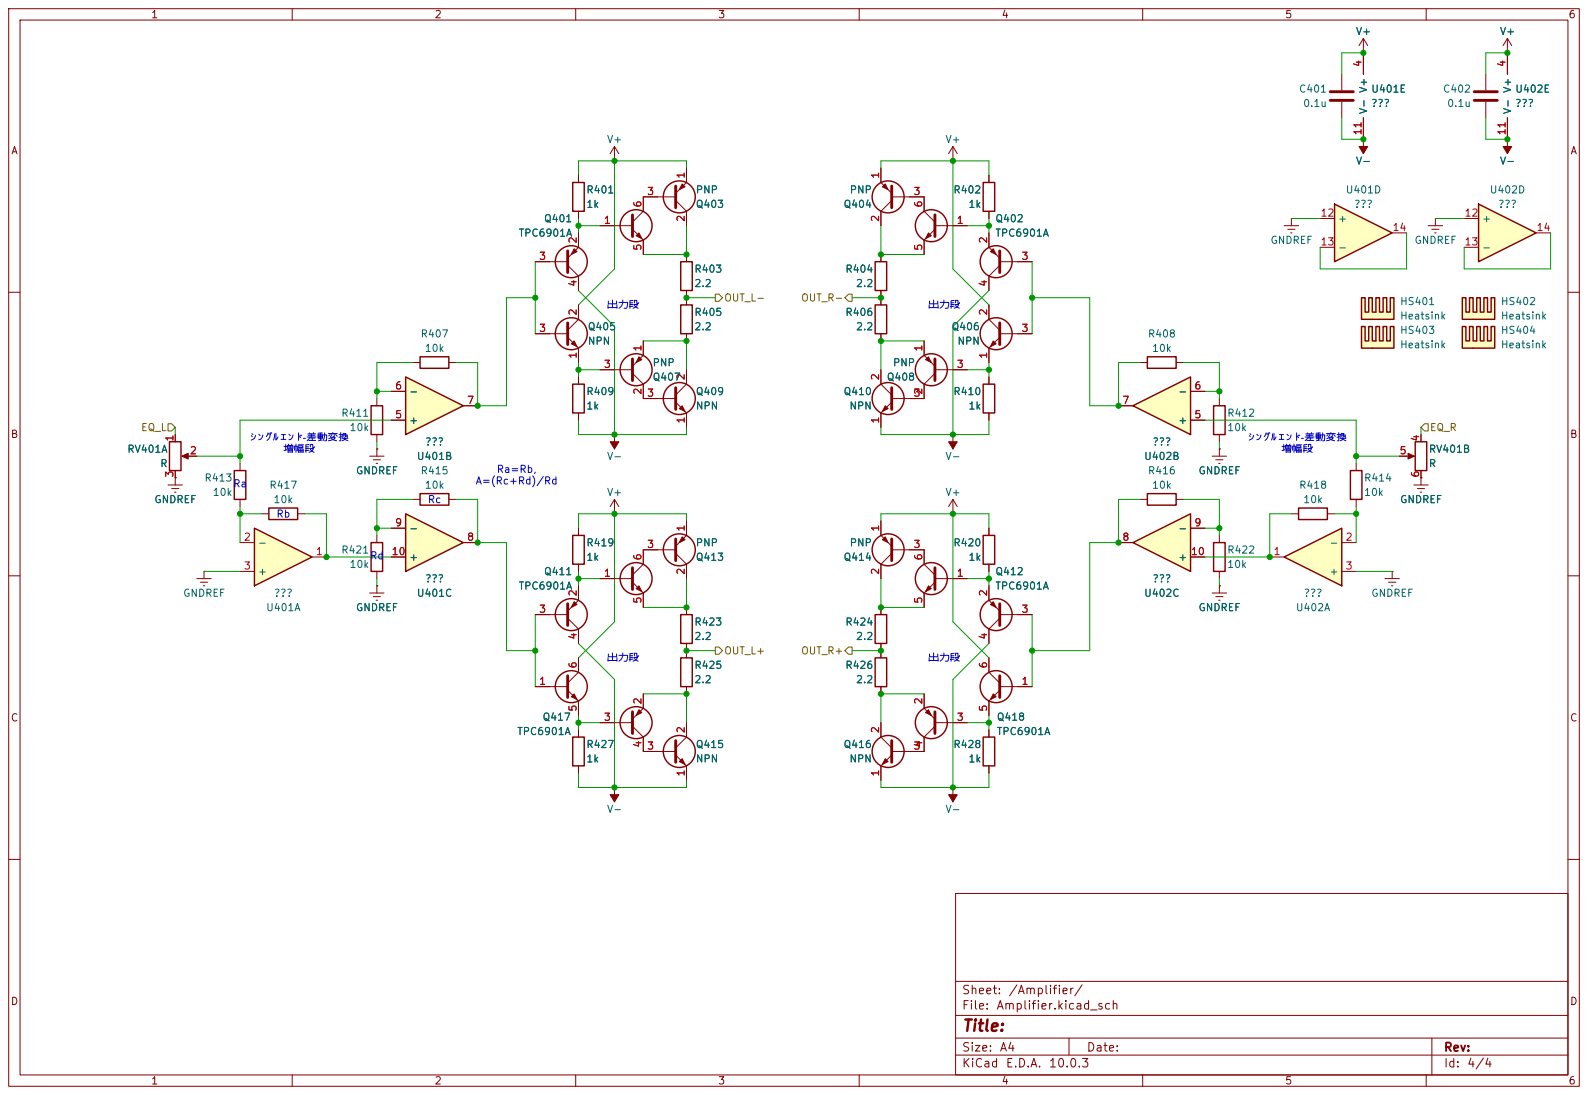
[picture p19: page 1]

Size: A4 | Rev:
KiCad E.D.A. 10.0.3 | Id: 4/4
