Yu-hotspring/BM83/(commit log)

2026-07-01 add gitignore
    [BM83.kicad_pcb, BM83.kicad_sch]
2026-07-02 ADC,充電管理IC，DCDC，CH32記載
    [BM83.kicad_sch]
2026-07-11 回路図更新
    [BM83.kicad_sch]
2026-07-11 回路図更新，昇圧どうしようね
    [BM83.kicad_sch]
2026-07-25 構成仮決定，sch内に記載
    [BM83.kicad_sch]
2026-07-29 差動変換とか書いた
    [BM83.kicad_sch]
2026-08-06 回路図ほぼ書いて整えた
    [Amplifier.kicad_sch, BM83.kicad_sch, DAC.kicad_sch, Equalizer.kicad_sch, Power.kicad_sch]
2026-08-06 回路図ひとまず完成
    [Amplifier.kicad_sch, BM83.kicad_sch, DAC.kicad_sch, Equalizer.kicad_sch, Power.kicad_sch]
2026-08-10 Amplifier回路図更新
2026-08-18 部品ほぼ割り当て
2026-09-25 何やってたか忘れた
2026-10-26 部品配置すすめた
2026-10-27 回路図一部変更，部品ほぼ置いた 寝かせる
2026-10-29 部品配置進行中
2026-10-29 アナログ部分以外ほぼ完成
2026-10-31 Volumeの種類と位置変えた
2026-11-01 残りGNDREFのみ，STEP出力した
2026-11-02 PCB更新
2026-11-02 残りシルク整理
2026-11-02 定数修正，シルク調整完了，基板完成
2026-11-02 基板名等追記
2026-11-02 BOM作製
2026-11-03 README更新，エミッタ抵抗まずくない？
2026-11-03 README更新
2026-11-03 定数，PCB，README更新
